SzalonyB/PE1_documents/PE1 Fail/BOM for PE1.txt

https://www.lcsc.com/product-detail/C165948.html 						USB-C 10 pieces 1.68$
https://www.lcsc.com/product-detail/C5349982.html 						LM2576S 6 pieces 4.54$
https://www.lcsc.com/product-detail/C5123950.html 						IRF7343 10 pieces 3.15$
https://www.lcsc.com/product-detail/C19271437.html 						ANR6045 coil 10 pieces 0.53$
https://www.lcsc.com/product-detail/C30584801.html 						YLED1206G 50 pieces 0.82$
https://www.lcsc.com/product-detail/C545323.html 						Zener Diode 3.3V 20 pieces 0.37$
https://www.lcsc.com/product-detail/C221869.html?s_z=n_PTS645					button 4 pieces 1.67$
https://www.lcsc.com/product-detail/C191023.html 						Schottky diode 50 pieces 0.52$
https://www.lcsc.com/product-detail/C2907370.html 						10K ohm 100 pieces 0.33$
https://www.lcsc.com/product-detail/C2907440.html						1K ohm 100 pieces 0.27$
https://www.lcsc.com/product-detail/C137393.html?s_z=n_resistors%25201206 			100K ohm 100 pieces 0.46$
https://www.lcsc.com/product-detail/C2907369.html?s_z=n_resistors%25201206			100 ohm 100 pieces 0.33$
https://www.lcsc.com/product-detail/C2933642.html?s_z=n_resistors%25201206%2520220%2520		220 ohm 100 pieces 0.31$
https://www.lcsc.com/product-detail/C2933655.html?s_z=n_resistors%25201206%2520270		270 omh 100 pieces 0.35$
https://www.lcsc.com/product-detail/C2933748.html?s_z=n_resistors%25201206%252068K		68k omh 100 pieces 0.36$
https://www.lcsc.com/product-detail/C15008.html?s_z=n_1206%2520capacitor%2520100uF 		100uF 10 pieces 0.61$
https://www.lcsc.com/product-detail/C5137623.html?s_z=n_1206%2520capacitor%252010nF      	10nf 50 pieces 0.48$ 
https://www.lcsc.com/product-detail/C13832.html?s_z=n_1206%2520capacitor%25201uF		1uF 10 pieces 0.25$
https://www.lcsc.com/product-detail/C24497.html?s_z=n_1206%2520capacitor%2520100nF		100nF 20 pieces 0.31$
