SzalonyB/PE1_documents/PROJECT_1_V2.kicad_pcb

## KiCad design PROJECT_1_V2.kicad_pcb (2026-07-12)

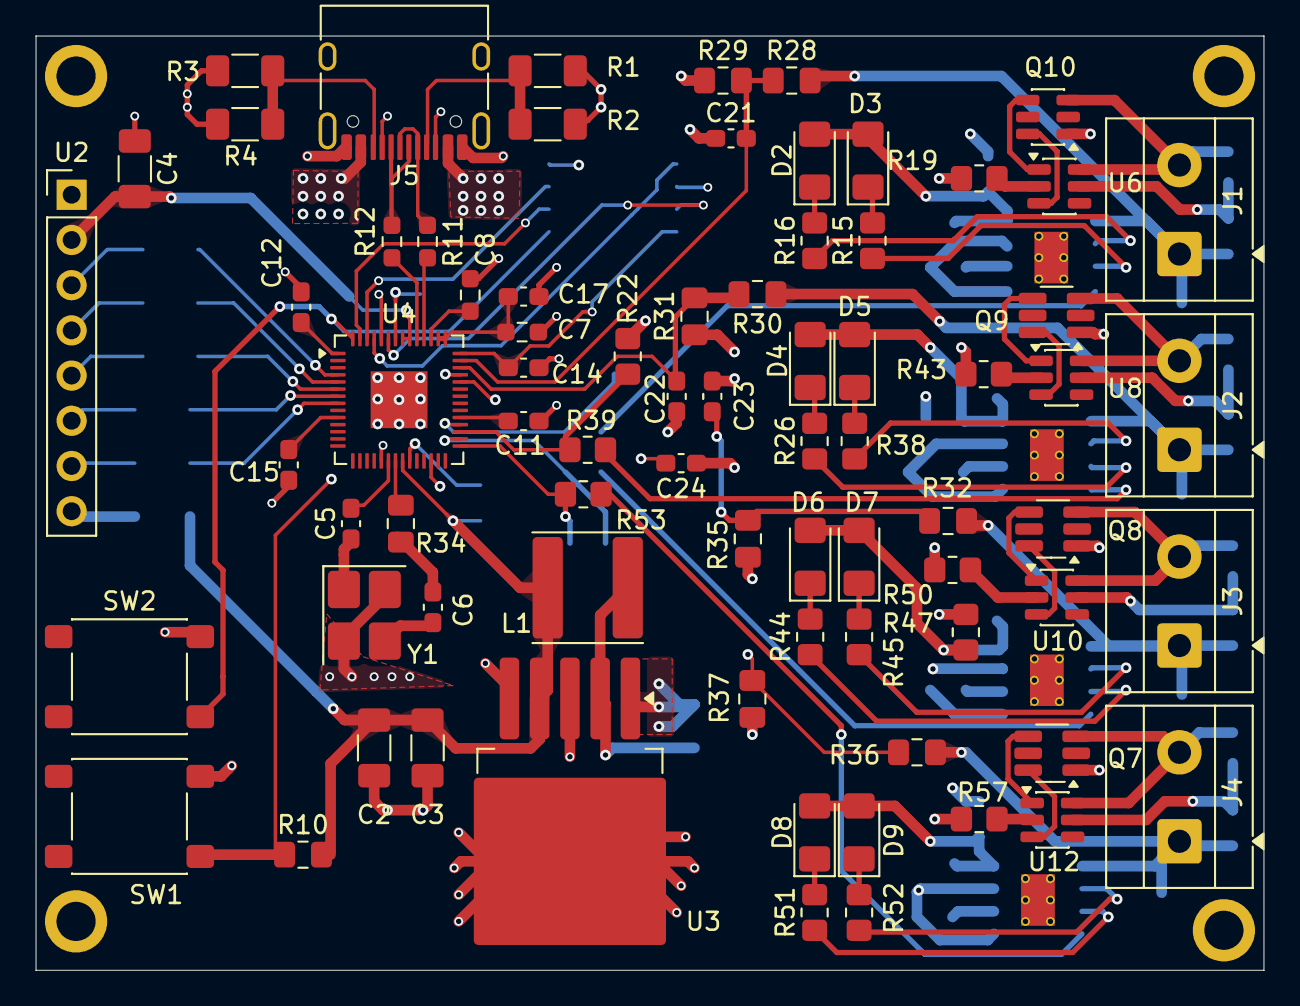
[picture p1: board PROJECT_1_V2.kicad_pcb from above]

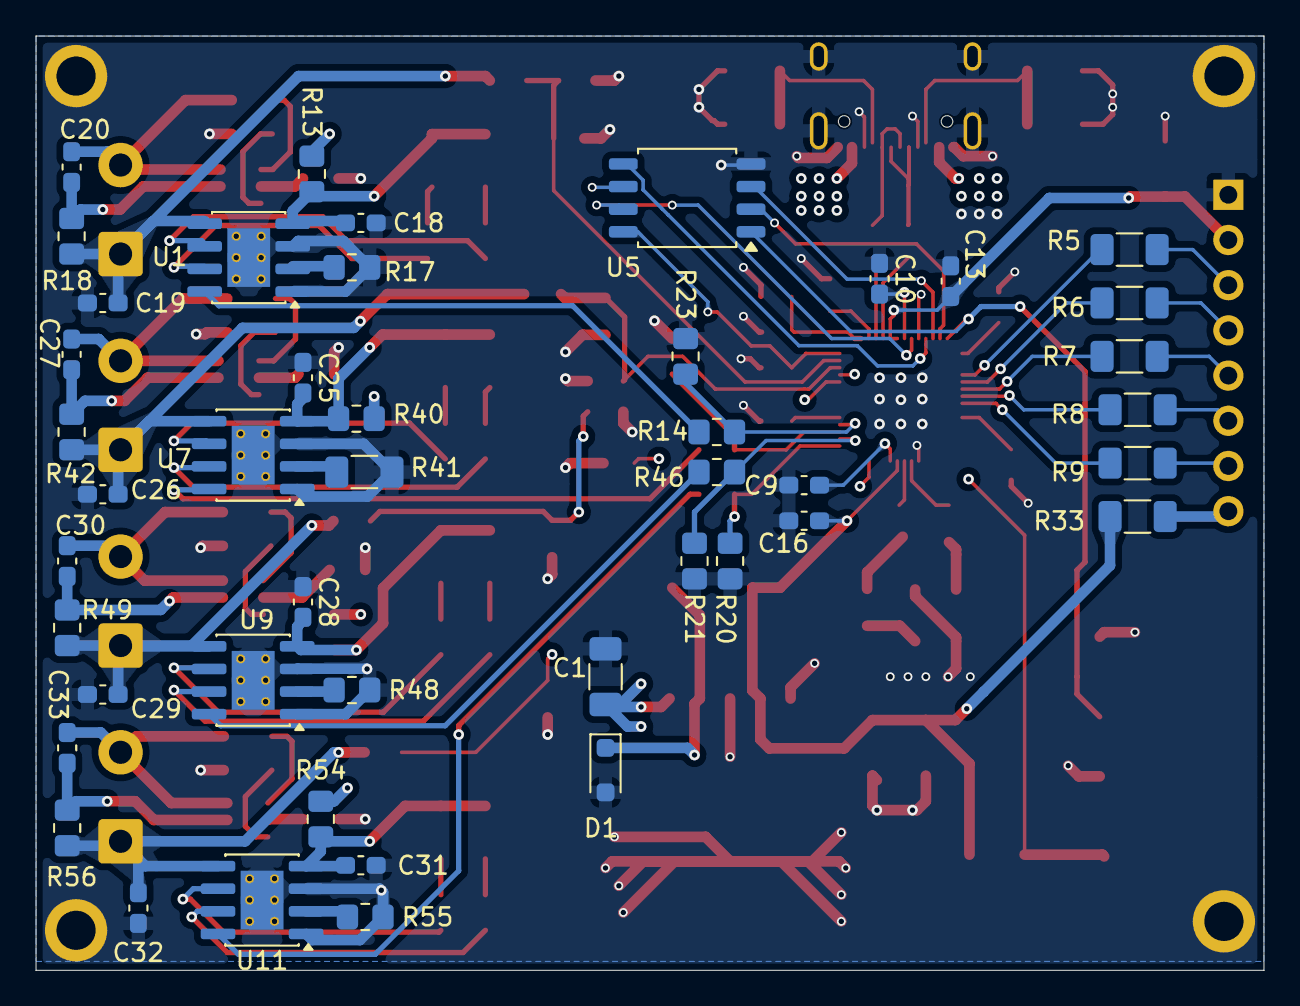
[picture p2: board PROJECT_1_V2.kicad_pcb from below]

Board: 4 copper layers, 69.0 x 52.5 mm, 125 parts (45 on the bottom side), 94 nets.

Parts:
C1, C2: 100uF; C_1206_3216Metric_Pad1.33x1.80mm_HandSolder
C3: 10nF; C_1206_3216Metric_Pad1.33x1.80mm_HandSolder
C4: 100nF; C_1206_3216Metric_Pad1.33x1.80mm_HandSolder
C5, C6: 15pF; C_0603_1608Metric_Pad1.08x0.95mm_HandSolder
C7: 1uf; R_0603_1608Metric_Pad0.98x0.95mm_HandSolder
C8: 1uF; R_0603_1608Metric_Pad0.98x0.95mm_HandSolder
C9, C10, C11, C12, C13, C14, C15, C16, C17, C20, C21, C22, C23, C24, C27, C30, C33: 100nF; C_0603_1608Metric_Pad1.08x0.95mm_HandSolder
C18, C19, C25, C26, C28, C29, C31, C32: 10uF; C_0603_1608Metric_Pad1.08x0.95mm_HandSolder
D1: 1N5892WS; D_SOD-323_HandSoldering
D2, D5, D7, D9: R LED; LED_1206_3216Metric_Pad1.42x1.75mm_HandSolder
D3, D4, D6, D8: G LED; LED_1206_3216Metric_Pad1.42x1.75mm_HandSolder
H1, H2, H3, H4: MountingHole_Pad; MountingHole_2.2mm_M2_ISO7380_Pad
J1, J2, J3, J4: Battery Input; TerminalBlock_MetzConnect_Type055_RT01502HDWU_1x02_P5.00mm_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
J5: USB_C_Receptacle_USB2.0_16P; USB_C_Receptacle_HRO_TYPE-C-31-M-12
L1: 100uH; L_APV_ANR6045
Q7, Q8, Q9: DMG9926UDM; SOT-23-6_Handsoldering
Q10: DMG9926UDM; SOT-23-6
R1, R2, R3, R4, R5, R6, R7, R9: 10k; R_1206_3216Metric_Pad1.30x1.75mm_HandSolder
R8: 1K; R_1206_3216Metric_Pad1.30x1.75mm_HandSolder
R10: 10K; C_0805_2012Metric_Pad1.18x1.45mm_HandSolder
R11, R12: 27; R_0603_1608Metric_Pad0.98x0.95mm_HandSolder
R13, R40, R47, R54: 0.5; R_0805_2012Metric_Pad1.20x1.40mm_HandSolder
R14, R15, R16, R26, R38, R39, R44, R45, R46, R51, R52, R53: 1k; R_0805_2012Metric_Pad1.20x1.40mm_HandSolder
R17, R48, R55: 1.2k; R_0805_2012Metric_Pad1.20x1.40mm_HandSolder
R18, R42, R49, R56: 100; R_0805_2012Metric_Pad1.20x1.40mm_HandSolder
R19, R43, R50, R57: 2k; R_0805_2012Metric_Pad1.20x1.40mm_HandSolder
R20, R21, R22, R23: 100k; R_0805_2012Metric_Pad1.20x1.40mm_HandSolder
R28, R30, R32, R36: 10k; C_0805_2012Metric_Pad1.18x1.45mm_HandSolder
R29, R31, R35, R37: 20k; C_0805_2012Metric_Pad1.18x1.45mm_HandSolder
R33: 220; R_1206_3216Metric_Pad1.30x1.75mm_HandSolder
R34: 1K; C_0805_2012Metric_Pad1.18x1.45mm_HandSolder
R41: 1.2k; R_1206_3216Metric_Pad1.30x1.75mm_HandSolder
SW1: RESET; SW_SPST_PTS645Sx43SMTR92
SW2: BOOT_LOADER; SW_SPST_PTS645Sx43SMTR92
U1, U7, U9: TP4056; SOIC-8-1EP_3.9x4.9mm_P1.27mm_EP2.41x3.3mm_ThermalVias
U2: Nokia_5110_LCD; PinHeader_1x08_P2.54mm_Vertical
U3: LM2576T-3.3; TO-263-5_TabPin3
U4: RP2040; QFN-56-1EP_7x7mm_P0.4mm_EP3.2x3.2mm
U5: W25Q128JVS; SOIC-8_5.3x5.3mm_P1.27mm
U6, U8, U10, U12: DW01A; SOT-23-6
U11: TP4056-42-ESOP8; SOIC-8-1EP_3.9x4.9mm_P1.27mm_EP2.41x3.3mm_ThermalVias
Y1: Crystal; Crystal_SMD_3225-4Pin_3.2x2.5mm_HandSoldering

Connections:
+1V1: C8.2, C9.2, C10.2, U4.23 (DVDD), U4.45 (VREG_VOUT), U4.50 (DVDD)
+3.3V: C2.2, C3.2, C4.2, C7.2, C11.2, C12.2, C13.2, C14.2, C15.2, C16.2, C17.2, L1.2, R10.2, R33.1, U2.2 (VCC), U3.4 (FB), U4.1 (IOVDD), U4.10 (IOVDD), U4.22 (IOVDD), U4.33 (IOVDD), U4.42 (IOVDD), U4.43 (ADC_AVDD), U4.44 (VREG_VIN), U4.48 (USB_VDD), U4.49 (IOVDD), U5.8 (VCC)
+5V: C1.2, J5.A4 (VBUS), J5.A9 (VBUS), J5.B4 (VBUS), J5.B9 (VBUS), R13.2, R40.2, R47.2, R54.2, U3.1 (VIN)
BAT+_1: C19.2, J1.1, R18.2, R28.2, U1.5 (BAT)
BAT+_2: C26.2, J2.1, R30.1, R42.2, U7.5 (BAT)
BAT+_3: C29.2, J3.1, R32.1, R49.2, U9.5 (BAT)
BAT+_4: C32.2, J4.1, R36.1, R56.2, U11.5 (BAT)
BOOT: SW2.1, U4.56 (~QSPI_SS), U5.1 (~CS)
CLK: R5.1, U4.4 (GPIO2)
CS: R8.1, U4.7 (GPIO5)
D+: J5.A6 (D+), J5.B6 (D+), R12.1
D-: J5.A7 (D-), J5.B7 (D-), R11.1
DIN: R6.1, U4.5 (GPIO3)
D/C: R7.1, U4.6 (GPIO4)
GATE_1: R14.1, R23.2, U4.32 (GPIO21)
GATE_2: R22.2, R39.1, U4.31 (GPIO20)
GATE_3: R21.2, R46.1, U4.30 (GPIO19)
GATE_4: R20.2, R53.1, U4.29 (GPIO18)
GND: C1.1, C2.1, C3.1, C4.1, C7.1, C8.1, C9.1, C10.1, C11.1, C12.1, C13.1, C14.1, C15.1, C16.1, C17.1, C18.1, C19.1, C21.1, C22.1, C23.1, C24.1, C25.1, C26.1, C28.1, C29.1, C31.1, C32.1, D1.2 (A), H1.1 (1_1), H2.1 (1_1), H3.1 (1_1), H4.1 (1_1), J5.A1 (GND), J5.A8 (SBU1), J5.A12 (GND), J5.B1 (GND), J5.B8 (SBU2), J5.B12 (GND), J5.SH, Q7.1 (S1), Q8.1 (D1), Q9.1 (D1), Q10.1 (D1), R1.2, R2.2, R3.2, R4.2, R17.2, R19.2, R20.1, R21.1, R22.1, R23.1, R29.1, R31.1, R35.1, R37.1, R41.2, R43.2, R48.2, R50.2, R55.2, R57.2, SW1.2 (A), SW2.2 (A), U1.1 (TEMP), U1.3 (GND), U1.9 (EPAD), U2.1 (GND), U3.3 (GND), U3.5 (~ON/OFF), U4.19 (TESTEN), U4.57 (GND), U5.4 (GND), U7.1 (TEMP), U7.3 (GND), U7.9 (EPAD), U9.1 (TEMP), U9.3 (GND), U9.9 (EPAD), U11.1 (TEMP), U11.3 (GND), U11.9 (EPAD), Y1.2, Y1.4
unnamed: C5.1, Y1.1
unnamed: C6.1, Y1.3
unnamed: C6.2, R34.2
unnamed: D1.1 (K), L1.1, U3.2 (OUT)
unnamed: C18.2, D2.2 (A), D3.2 (A), R13.1, U1.4 (V_{CC})
unnamed: D2.1 (K), R16.2
unnamed: D3.1 (K), R15.2
unnamed: C25.2, D4.2 (A), D5.2 (A), R40.1, U7.4 (V_{CC})
unnamed: D4.1 (K), R26.2
unnamed: D5.1 (K), R38.2
unnamed: C28.2, D6.2 (A), D7.2 (A), R47.1, U9.4 (V_{CC})
unnamed: D6.1 (K), R44.2
unnamed: D7.1 (K), R45.2
unnamed: C31.2, D8.2 (A), D9.2 (A), R54.1, U11.4 (V_{CC})
unnamed: D8.1 (K), R51.2
unnamed: D9.1 (K), R52.2
unnamed: C20.1, J1.2, Q10.3 (S2), U6.6 (GND)
unnamed: C27.1, J2.2, Q9.3 (S2), U8.6 (GND)
unnamed: C30.1, J3.2, Q8.3 (S2), U10.6 (GND)
unnamed: C33.1, J4.2, Q7.3 (S2), U12.6 (GND)
unnamed: J5.A5 (CC1), R1.1, R2.1
unnamed: J5.B5 (CC2), R3.1, R4.1
unnamed: Q7.6 (G1), U12.3 (OC)
unnamed: Q7.4 (G2), U12.1 (OD)
unnamed: Q8.6 (G1), U10.3 (OC)
unnamed: Q8.4 (G2), U10.1 (OD)
unnamed: Q9.6 (G1), U8.3 (OC)
unnamed: Q9.4 (G2), U8.1 (OD)
unnamed: Q10.6 (G1), U6.3 (OC)
unnamed: Q10.4 (G2), U6.1 (OD)
unnamed: R14.2, U1.8 (CE)
unnamed: R17.1, U1.2 (PROG)
unnamed: R15.1, U1.7 (~CHRG)
unnamed: R16.1, U1.6 (~STDBY)
unnamed: R5.2, U2.3 (CLK)
unnamed: R8.2, U2.6 (CS)
unnamed: R6.2, U2.4 (DIN)
unnamed: R7.2, U2.5 (D/~C)
unnamed: R33.2, U2.8 (LED)
unnamed: R9.2, U2.7 (~RST)
unnamed: R11.2, U4.46 (USB_DM)
unnamed: R12.2, U4.47 (USB_DP)
unnamed: R19.1, U6.2 (CS)
unnamed: C20.2, R18.1, U6.5 (VCC)
unnamed: R39.2, U7.8 (CE)
unnamed: R41.1, U7.2 (PROG)
unnamed: R26.1, U7.7 (~CHRG)
unnamed: R38.1, U7.6 (~STDBY)
unnamed: R43.1, U8.2 (CS)
unnamed: C27.2, R42.1, U8.5 (VCC)
unnamed: R46.2, U9.8 (CE)
unnamed: R48.1, U9.2 (PROG)
unnamed: R44.1, U9.7 (~CHRG)
unnamed: R45.1, U9.6 (~STDBY)
unnamed: R50.1, U10.2 (CS)
unnamed: C30.2, R49.1, U10.5 (VCC)
unnamed: R53.2, U11.8 (CE)
unnamed: R55.1, U11.2 (PROG)
unnamed: R51.1, U11.7 (~CHRG)
unnamed: R52.1, U11.6 (~STDBY)
unnamed: R57.1, U12.2 (CS)
unnamed: C33.2, R56.1, U12.5 (VCC)
QSPI_SCLK: U4.52 (QSPI_SCLK), U5.6 (CLK)
QSPI_SD0: U4.53 (QSPI_SD0), U5.5 (DI/IO_{0})
QSPI_SD1: U4.55 (QSPI_SD1), U5.2 (DO/IO_{1})
QSPI_SD2: U4.54 (QSPI_SD2), U5.3 (~WP/IO_{2})
QSPI_SD3: U4.51 (QSPI_SD3), U5.7 (~HOLD/~RESET/IO_{3})
RST: R9.1, U4.8 (GPIO6)
RUN: R10.1, SW1.1, U4.26 (RUN)
V_Sense1: C21.2, R28.1, R29.2, U4.41 (GPIO29/ADC3)
V_Sense2: C22.2, R30.2, R31.2, U4.40 (GPIO28/ADC2)
V_Sense3: C23.2, R32.2, R35.2, U4.39 (GPIO27/ADC1)
V_Sense4: C24.2, R36.2, R37.2, U4.38 (GPIO26/ADC0)
XIN: C5.2, U4.20 (XIN)
XOUT: R34.1, U4.21 (XOUT)
