SzalonyB/PE1_documents/PE1 Fail/PROJECT_ENTERPRISE_1.kicad_pcb

## KiCad design PE1 Fail/PROJECT_ENTERPRISE_1.kicad_pcb (2026-05-22)

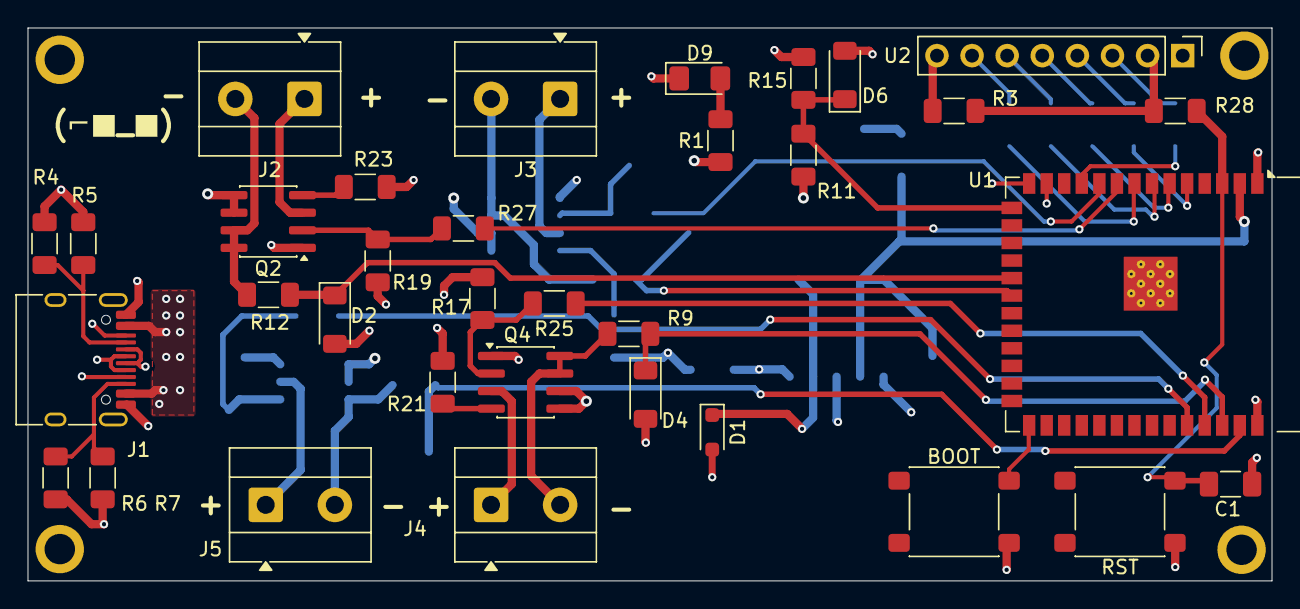
[picture p3: board PROJECT_ENTERPRISE_1.kicad_pcb from above]

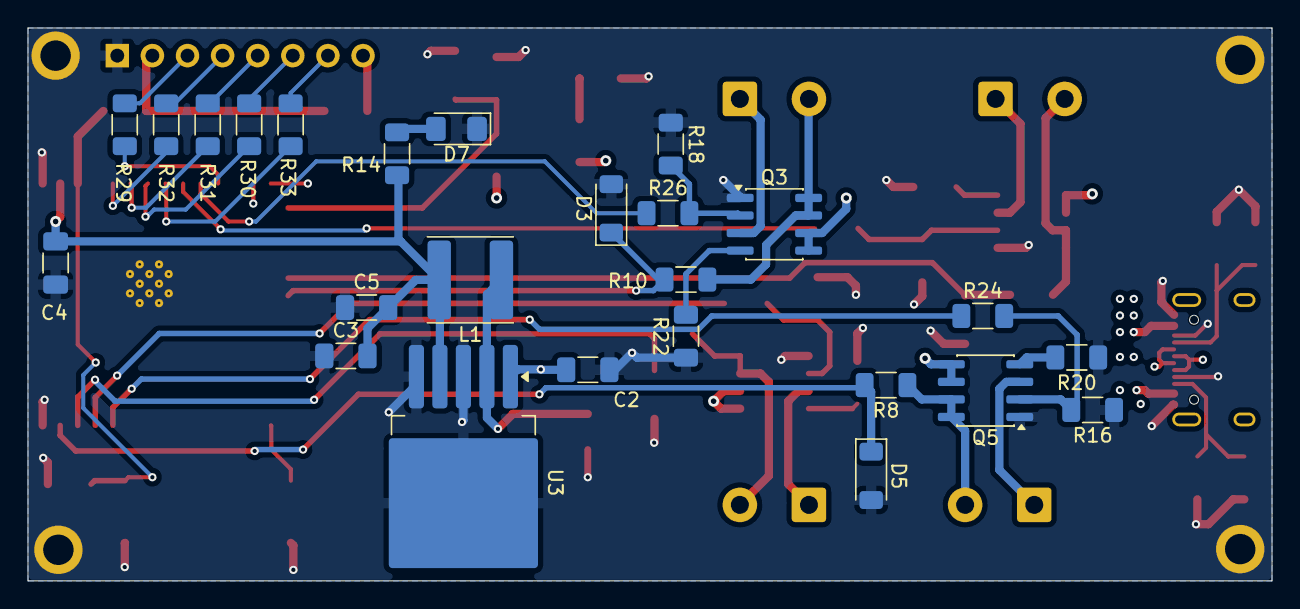
[picture p4: board PROJECT_ENTERPRISE_1.kicad_pcb from below]

Board: 4 copper layers, 90.0 x 40.0 mm, 63 parts (25 on the bottom side), 48 nets.

Parts:
BOOT: BOOT_LOADER; SW_SPST_PTS645Sx43SMTR92
C1: 1uF; C_1206_3216Metric_Pad1.33x1.80mm_HandSolder
C2, C3: 100uF; C_1206_3216Metric_Pad1.33x1.80mm_HandSolder
C4: 100nF; C_1206_3216Metric_Pad1.33x1.80mm_HandSolder
C5: 10nF; C_1206_3216Metric_Pad1.33x1.80mm_HandSolder
D1: 1N5892WS; D_SOD-323_HandSoldering
D2, D3, D4, D5, D6: BZV55C3V3; D_MiniMELF
D7, D9: LED; LED_1206_3216Metric_Pad1.42x1.75mm_HandSolder
H1, H2, H3, H4: MountingHole_Pad; MountingHole_2.2mm_M2_ISO7380_Pad
J1: USB_C_Receptacle_USB2.0_16P; USB_C_Receptacle_HRO_TYPE-C-31-M-12
J2, J3, J4, J5: Battery Input; TerminalBlock_MetzConnect_Type055_RT01502HDWU_1x02_P5.00mm_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
L1: 100uH; L_APV_ANR6045
Q2, Q3, Q4, Q5: IRF7343PBF; SOIC-8_3.9x4.9mm_P1.27mm
R1: 820; R_1206_3216Metric_Pad1.30x1.75mm_HandSolder
R3: 220; R_1206_3216Metric_Pad1.30x1.75mm_HandSolder
R4, R5, R6, R7, R28, R29, R31, R32, R33: 10k; R_1206_3216Metric_Pad1.30x1.75mm_HandSolder
R8, R9, R10, R12, R30: 1K; R_1206_3216Metric_Pad1.30x1.75mm_HandSolder
R11: 68K; R_1206_3216Metric_Pad1.30x1.75mm_HandSolder
R14: 680; R_1206_3216Metric_Pad1.30x1.75mm_HandSolder
R15, R16, R17, R18, R19, R20, R21, R22, R23: 100K; R_1206_3216Metric_Pad1.30x1.75mm_HandSolder
R24, R25, R26, R27: 100; R_1206_3216Metric_Pad1.30x1.75mm_HandSolder
RST: RST; SW_SPST_PTS645Sx43SMTR92
U1: ESP32-S3-WROOM-1
U2: Nokia_5110_LCD; PinHeader_1x08_P2.54mm_Vertical
U3: LM2576T-3.3; TO-263-5_TabPin3

Connections:
+3.3V: C3.2, C4.2, C5.2, L1.2, R3.1, R14.1, R28.1, U1.2 (3V3), U2.2 (VCC), U3.4 (FB)
+5V: C2.2, J1.A4 (VBUS), J1.A9 (VBUS), J1.B4 (VBUS), J1.B9 (VBUS), Q2.5 (D2), Q2.6 (D2), Q3.5 (D2), Q3.6 (D2), Q4.5 (D2), Q4.6 (D2), Q5.5 (D2), Q5.6 (D2), R1.1, R11.2, U3.1 (VIN)
A_Sense1: D5.1 (K), R8.2, U1.39 (IO1)
A_Sense2: D4.1 (K), R9.2, U1.38 (IO2)
A_Sense3: D3.1 (K), R10.2, U1.20 (IO12)
A_Sense4: D2.1 (K), R12.2, U1.19 (IO11)
BOOT: BOOT.3 (B), BOOT.4 (B), U1.27 (IO0)
CLK: R29.1, U1.11 (IO18)
CS: R30.1, U1.7 (IO7)
D+: J1.A6 (D+), J1.B6 (D+), U1.14 (USB_D+)
D-: J1.A7 (D-), J1.B7 (D-), U1.13 (USB_D-)
DIN: R32.1, U1.5 (IO5)
D/C: R31.1, U1.6 (IO6)
EN: C1.1, R28.2, RST.1 (A), RST.2 (A), U1.3 (EN)
GATE_1: R24.1, U1.36 (RXD0)
GATE_2: R25.1, U1.37 (TXD0)
GATE_3: R26.1, U1.10 (IO17)
GATE_4: R27.1, U1.9 (IO16)
GND: BOOT.1 (A), BOOT.2 (A), C1.2, C2.1, C3.1, C4.1, C5.1, D1.2 (A), D2.2 (A), D3.2 (A), D4.2 (A), D5.2 (A), D6.2 (A), D7.1 (K), D9.1 (K), H1.1 (1_1), H2.1 (1_1), H3.1 (1_1), H4.1 (1_1), J1.A1 (GND), J1.A8 (SBU1), J1.A12 (GND), J1.B1 (GND), J1.B8 (SBU2), J1.B12 (GND), Q2.1 (S1), Q3.1 (S1), Q4.1 (S1), Q5.1 (S1), R4.2, R5.2, R6.2, R7.2, R15.1, R16.1, R17.1, R18.1, R19.1, R20.1, R21.1, R22.1, R23.1, RST.3 (B), RST.4 (B), U1.1 (GND), U1.40 (GND), U1.41 (GND), U2.1 (GND), U3.3 (GND), U3.5 (~ON/OFF)
unnamed: D1.1 (K), L1.1, U3.2 (OUT)
unnamed: D7.2 (A), R14.2
unnamed: D9.2 (A), R1.2
unnamed: J1.A5 (CC1), R4.1, R5.1
unnamed: J1.B5 (CC2), R6.1, R7.1
unnamed: J2.1, Q2.3 (S2)
unnamed: J2.2, Q2.7 (D1), Q2.8 (D1), R12.1
unnamed: J3.1, Q3.3 (S2)
unnamed: J3.2, Q3.7 (D1), Q3.8 (D1), R10.1
unnamed: J4.1, Q4.3 (S2)
unnamed: J4.2, Q4.7 (D1), Q4.8 (D1), R9.1
unnamed: J5.1, Q5.3 (S2)
unnamed: J5.2, Q5.7 (D1), Q5.8 (D1), R8.1
unnamed: Q2.2 (G1), R19.2, R27.2
unnamed: Q2.4 (G2), R23.2
unnamed: Q3.2 (G1), R18.2, R26.2
unnamed: Q3.4 (G2), R22.2
unnamed: Q4.2 (G1), R17.2, R25.2
unnamed: Q4.4 (G2), R21.2
unnamed: Q5.2 (G1), R16.2, R24.2
unnamed: Q5.4 (G2), R20.2
unnamed: R29.2, U2.3 (CLK)
unnamed: R30.2, U2.6 (CS)
unnamed: R32.2, U2.4 (DIN)
unnamed: R31.2, U2.5 (D/~C)
unnamed: R3.2, U2.8 (LED)
unnamed: R33.2, U2.7 (~RST)
RST: R33.1, U1.8 (IO15)
V_Sense: D6.1 (K), R11.1, R15.2, U1.15 (IO3)
