SzalonyB/PE1_documents/(commit log)

2026-05-22 Added datasheets.
    [PROJECT_ENTERPRISE_1.kicad_pcb, PROJECT_ENTERPRISE_1.kicad_sch, get_me_this_pcb_rn_bom.csv, get_me_this_pcb_rn_designators.csv, get_me_this_pcb_rn_positions.csv]
2026-05-23 added the code
    [PROJECT_ENTERPRISE_1.kicad_sch]
2026-05-23 Added the rest
    [PROJECT_ENTERPRISE_1.kicad_pcb]
2026-05-23 Final product.
    [PROJECT_ENTERPRISE_1.kicad_pcb]
2026-07-06 V2 almost done
    [PROJECT_1_V2.kicad_pcb, PROJECT_1_V2.kicad_sch, PROJECT_ENTERPRISE_1.kicad_pcb, PROJECT_ENTERPRISE_1.kicad_sch, get_me_this_pcb_rn_bom.csv, get_me_this_pcb_rn_designators.csv, get_me_this_pcb_rn_positions.csv]
2026-07-12 Final result
    [PROJECT_1_V2.kicad_pcb, PROJECT_1_V2.kicad_sch, gerber_V2_bom.csv, gerber_V2_designators.csv, gerber_V2_positions.csv]
